lukerussell1/Guitar-Pedal-Project/Notes/clipping_stage_notes.jpg

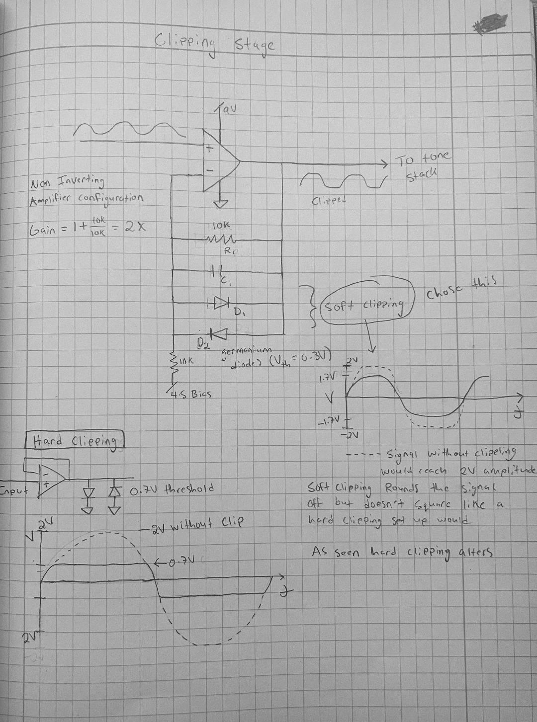
Notes/clipping_stage_notes.jpg
