lukerussell1/Guitar-Pedal-Project/Notes/tone_stack_notes.jpg

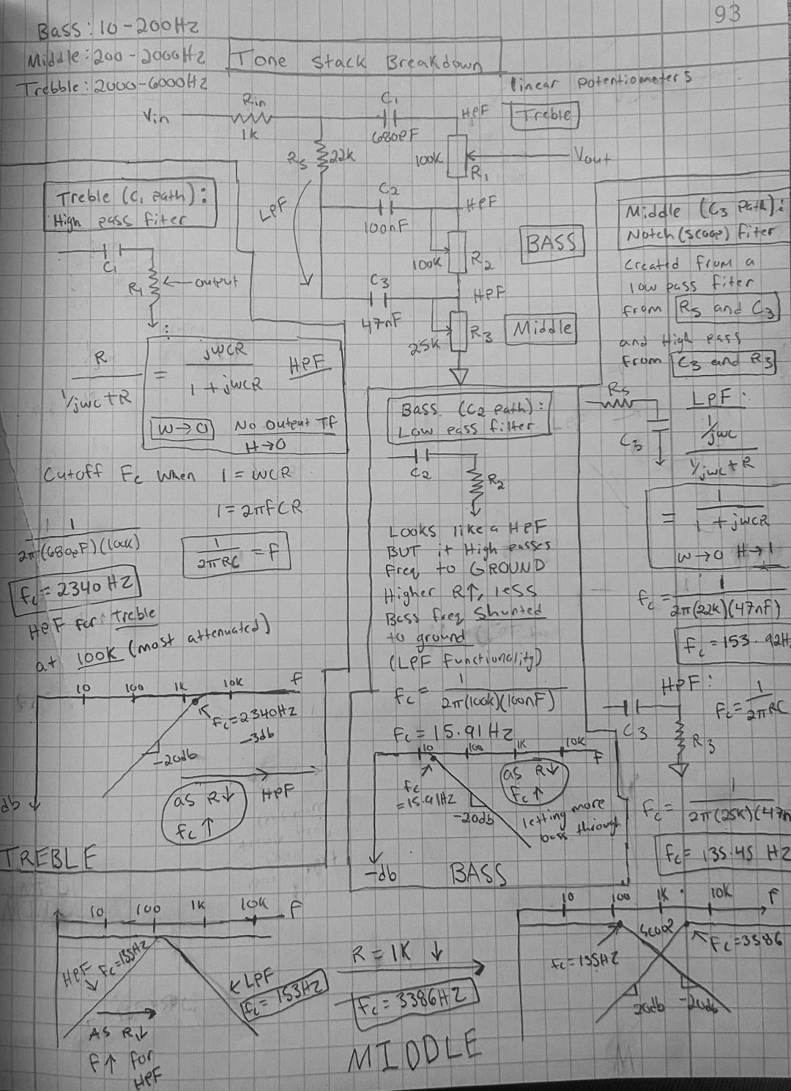
Notes/tone_stack_notes.jpg
