lukerussell1/Guitar-Pedal-Project/Full_Schematic_Picture.png

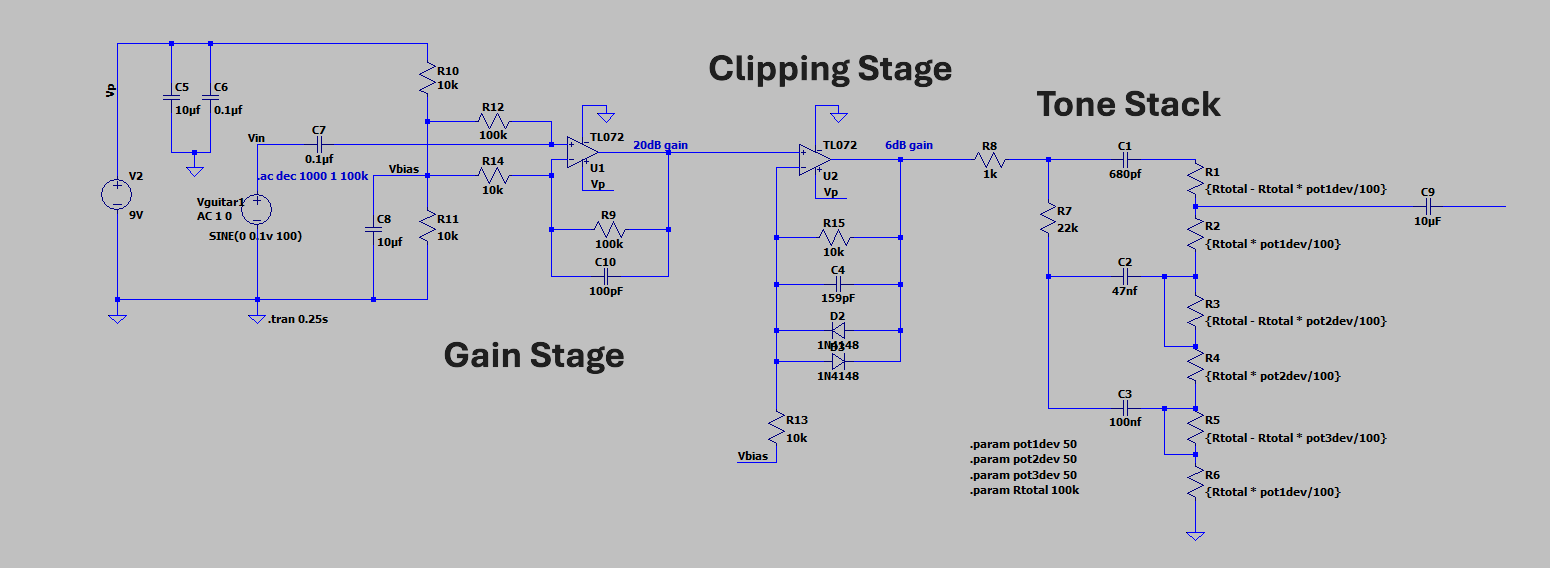
Full_Schematic_Picture.png
