lukerussell1/Guitar-Pedal-Project/Notes/gain_stage_notes.jpg

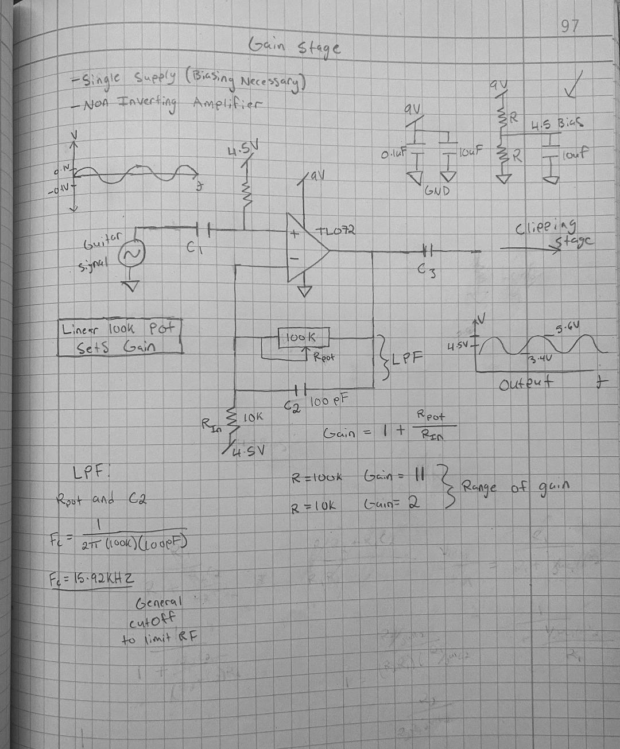
Notes/gain_stage_notes.jpg
