lukerussell1/Guitar-Pedal-Project/Guitar_Pedal_Sim.asc

C1: cap; 680pf
C2: cap; 47nf
C3: cap; 100nf
C4: cap; 159pF
C5: cap; 10µf
C6: cap; 0.1µf
C7: cap; 0.1µf
C8: cap; 10µf
C9: cap; 10µF
C10: cap; 100pF
D2: diode; 1N4148
D3: diode; 1N4148
R1: res; {Rtotal - Rtotal * pot1dev/100}
R2: res; {Rtotal * pot1dev/100}
R3: res; {Rtotal - Rtotal * pot2dev/100}
R4: res; {Rtotal * pot2dev/100}
R5: res; {Rtotal - Rtotal * pot3dev/100}
R6: res; {Rtotal * pot1dev/100}
R7: res; 22k
R8: res; 1k
R9: res; 100k
R10: res; 10k
R11: res; 10k
R12: res; 100k
R13: res; 10k
R14: res; 10k
R15: res; 10k
U1: opamp2; TL072
U2: opamp2; TL072
V2: voltage; 9V
Vguitar1: voltage; SINE(0 0.1v 100); AC 1 0
Named nets: Vp, 0, Vin, Vbias
.param pot1dev 50
.param pot2dev 50
.param pot3dev 50
.param Rtotal 100k
.tran 0.25s
* TL072 OPERATIONAL AMPLIFIER "MACROMODEL" SUBCIRCUIT
* CREATED USING PARTS RELEASE 4.01 ON 06/16/89 AT 13:08
* (REV N/A)      SUPPLY VOLTAGE: +/-15V
* CONNECTIONS:   NON-INVERTING INPUT
*                | INVERTING INPUT
*                | | POSITIVE POWER SUPPLY
*                | | | NEGATIVE POWER SUPPLY
*                | | | | OUTPUT
*                | | | | |
.SUBCKT TL072    1 2 3 4 5
*
  C1   11 12 3.498E-12
  C2    6  7 15.00E-12
  DC    5 53 DX
  DE   54  5 DX
  DLP  90 91 DX
  DLN  92 90 DX
  DP    4  3 DX
  EGND 99  0 POLY(2) (3,0) (4,0) 0 .5 .5
  FB    7 99 POLY(5) VB VC VE VLP VLN 0 4.715E6 -5E6 5E6 5E6 -5E6
  GA    6  0 11 12 282.8E-6
  GCM   0  6 10 99 8.942E-9
  ISS   3 10 DC 195.0E-6
  HLIM 90  0 VLIM 1K
  J1   11  2 10 JX
  J2   12  1 10 JX
  R2    6  9 100.0E3
  RD1   4 11 3.536E3
  RD2   4 12 3.536E3
  RO1   8  5 150
  RO2   7 99 150
  RP    3  4 2.143E3
  RSS  10 99 1.026E6
  VB    9  0 DC 0
  VC    3 53 DC 2.200
  VE   54  4 DC 2.200
  VLIM  7  8 DC 0
  VLP  91  0 DC 25
  VLN   0 92 DC 25
.MODEL DX D(IS=800.0E-18)
.MODEL JX PJF(IS=15.00E-12 BETA=270.1E-6 VTO=-1)
.ENDS
20dB gain
.ac dec 1000 1 100k
6dB gain
