lukerussell1/Guitar-Pedal-Project/Stage Simulations/clipping_stage_sim.asc

C1: cap; 150pF
C2: cap; 150pF
C3: cap; 150pF
D1: diode
D2: diode
D3: diode
D4: diode
R1: res; 10k
R2: res; 10k
R3: res; 10k
R4: res; 10k
R5: res; 10k
R6: res; 10k
U1: OP07
U2: OP07
U3: OP07
V1: voltage; 5
V2: voltage; -5
V3: voltage; SINE(0 1 400); AC 1V 0
V4: voltage; SINE(0 1 400); AC 1V 0
V5: voltage; SINE(0 1 400); AC 1V 0
Named nets: 0, V+, V-, Vsoft, Vhard, Vout
.tran 0.05
