lukerussell1/Guitar-Pedal-Project/Stage Simulations/tone_stack_sim.asc

C1: cap; 680pf
C2: cap; 47nf
C3: cap; 100nf
R1: res; {Rtotal - Rtotal * pot1dev/100}
R2: res; {Rtotal * pot1dev/100}
R3: res; {Rtotal - Rtotal * pot2dev/100}
R4: res; {Rtotal * pot2dev/100}
R5: res; {Rtotal - Rtotal * pot3dev/100}
R6: res; {Rtotal * pot1dev/100}
R7: res; 22k
R8: res; 4.6k
V1: voltage; SINE(0 1 400); AC 1 0
Named nets: 0, Vout
.param pot1dev 50
.param pot2dev 50
.param pot3dev 50
.ac dec 1000 10 100000
.param Rtotal 100k
